hahaokbk/project001/v05/CWIEM_PCB_v05.kicad_pcb

## KiCad design v05/CWIEM_PCB_v05.kicad_pcb (2015-06-16)

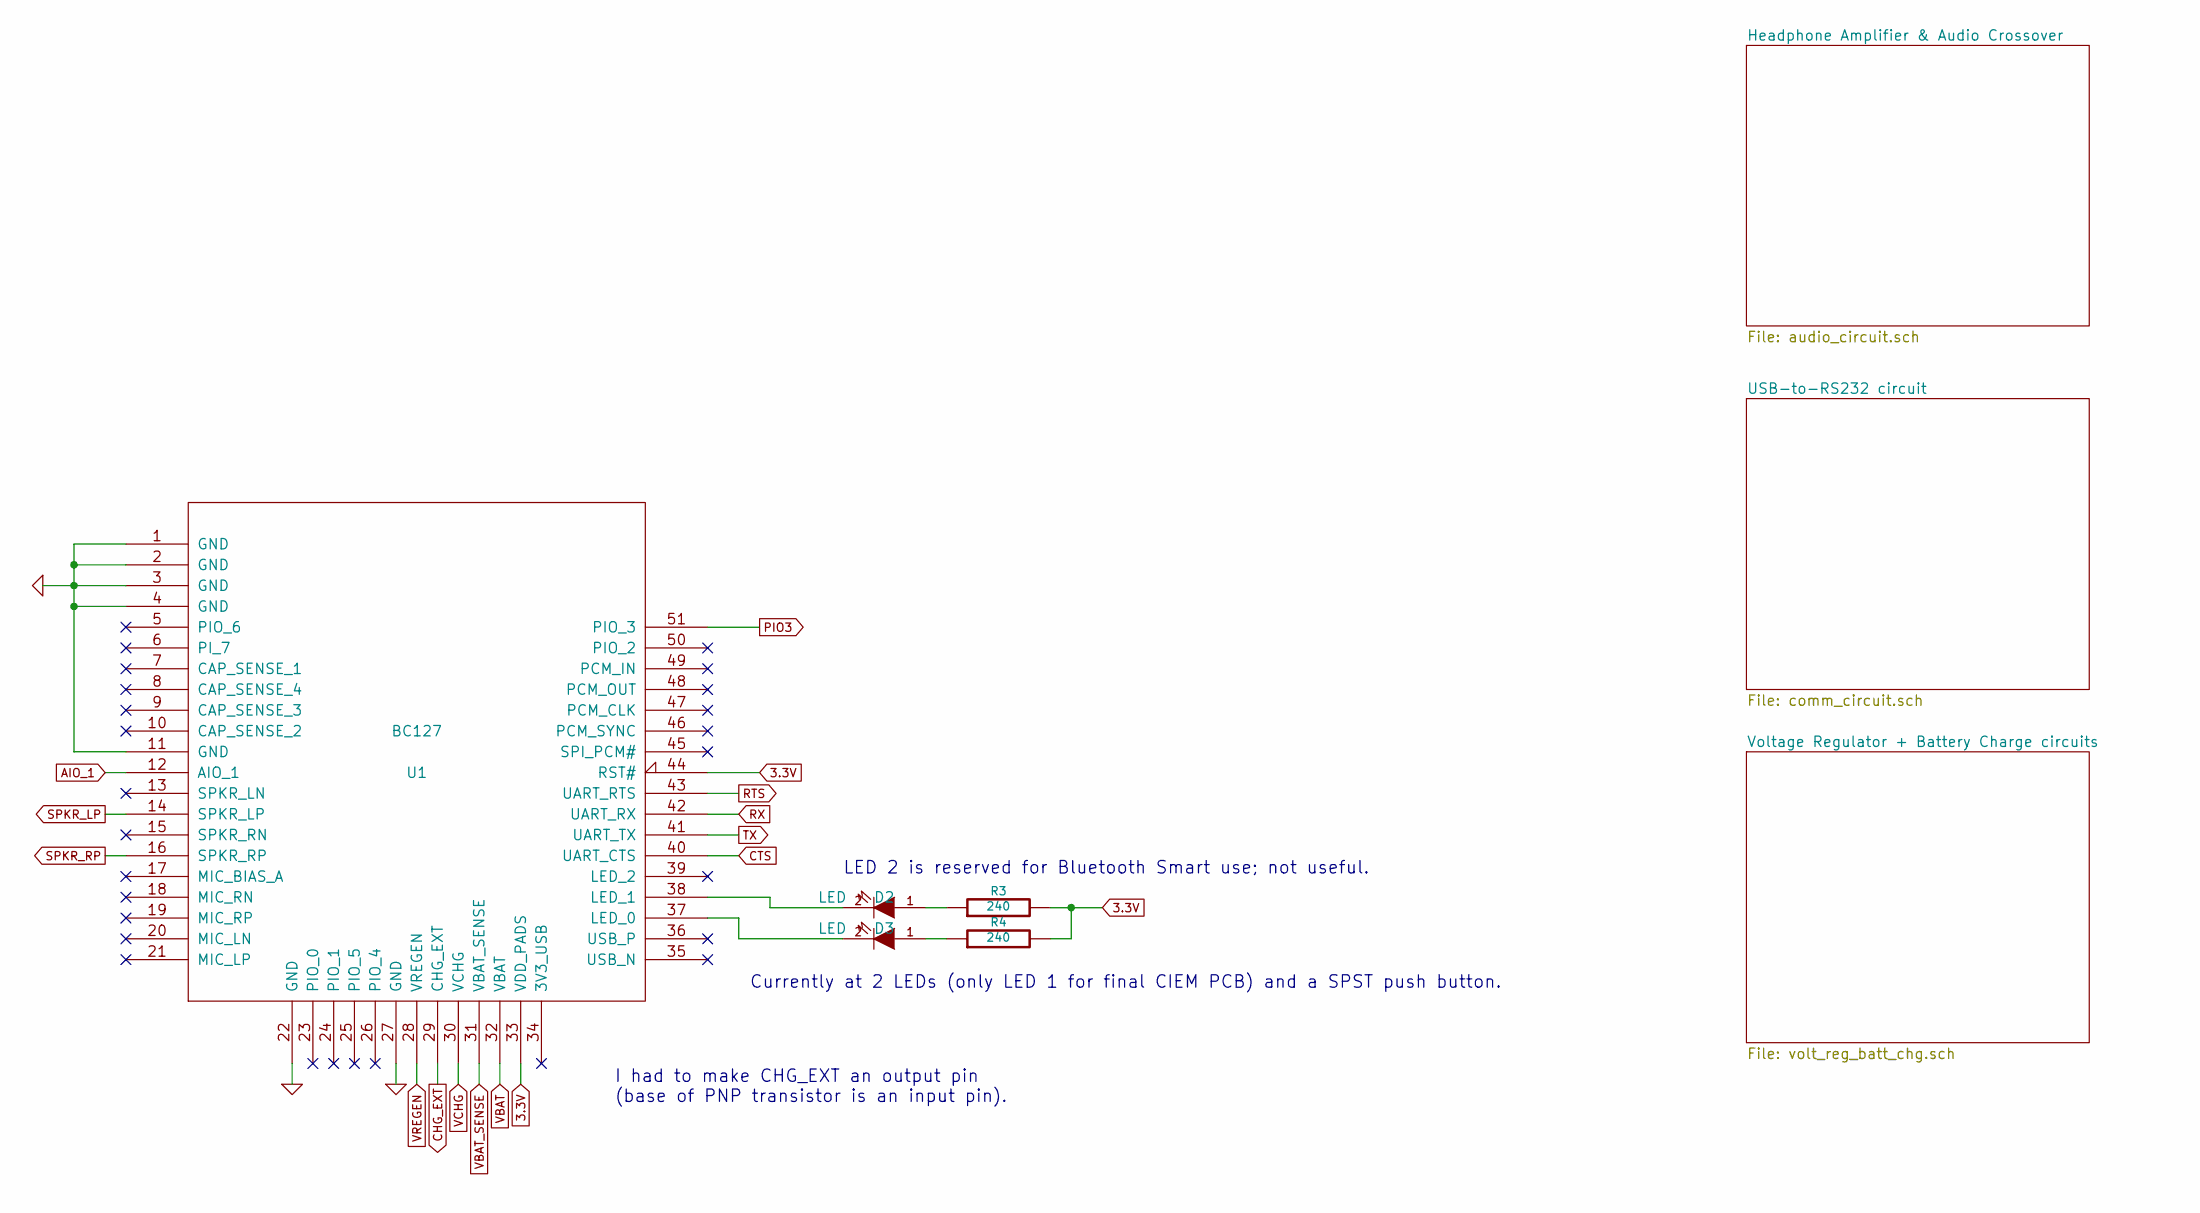
[picture p1: schematic CWIEM_PCB_v05.sch, BC127 circuit]

Parts:
D2, D3: LED
R3, R4: 240
U1: BC127; MODULE

Connections:
3.3V: R3.2, R4.2, U1.33 (VDD_PADS), U1.44 (RST#); also elsewhere on the board
5V_USB: U1.30 (VCHG); also elsewhere on the board
AIO_1: U1.12 (AIO_1); also elsewhere on the board
CHG_EXT: U1.29 (CHG_EXT); also elsewhere on the board
CTS: U1.40 (UART_CTS); also elsewhere on the board
GND: U1.1 (GND), U1.2 (GND), U1.3 (GND), U1.4 (GND), U1.11 (GND), U1.22 (GND), U1.27 (GND); also elsewhere on the board
unnamed: D3.2 (K), U1.37 (LED_0)
unnamed: D2.2 (K), U1.38 (LED_1)
unnamed: D2.1 (A), R3.1
unnamed: D3.1 (A), R4.1
PIO3: U1.51 (PIO_3); also elsewhere on the board
RTS: U1.43 (UART_RTS); also elsewhere on the board
RX: U1.42 (UART_RX); also elsewhere on the board
SPKR_LP: U1.14 (SPKR_LP); also elsewhere on the board
SPKR_RP: U1.16 (SPKR_RP); also elsewhere on the board
TX: U1.41 (UART_TX); also elsewhere on the board
VBAT: U1.32 (VBAT); also elsewhere on the board
VBAT_SENSE: U1.31 (VBAT_SENSE); also elsewhere on the board
VREGEN: U1.28 (VREGEN); also elsewhere on the board

Notes on the sheet:
Currently at 2 LEDs (only LED 1 for final CIEM PCB) and a SPST push button.
I had to make CHG_EXT an output pin (base of PNP transistor is an input pin).
LED 2 is reserved for Bluetooth Smart use; not useful.

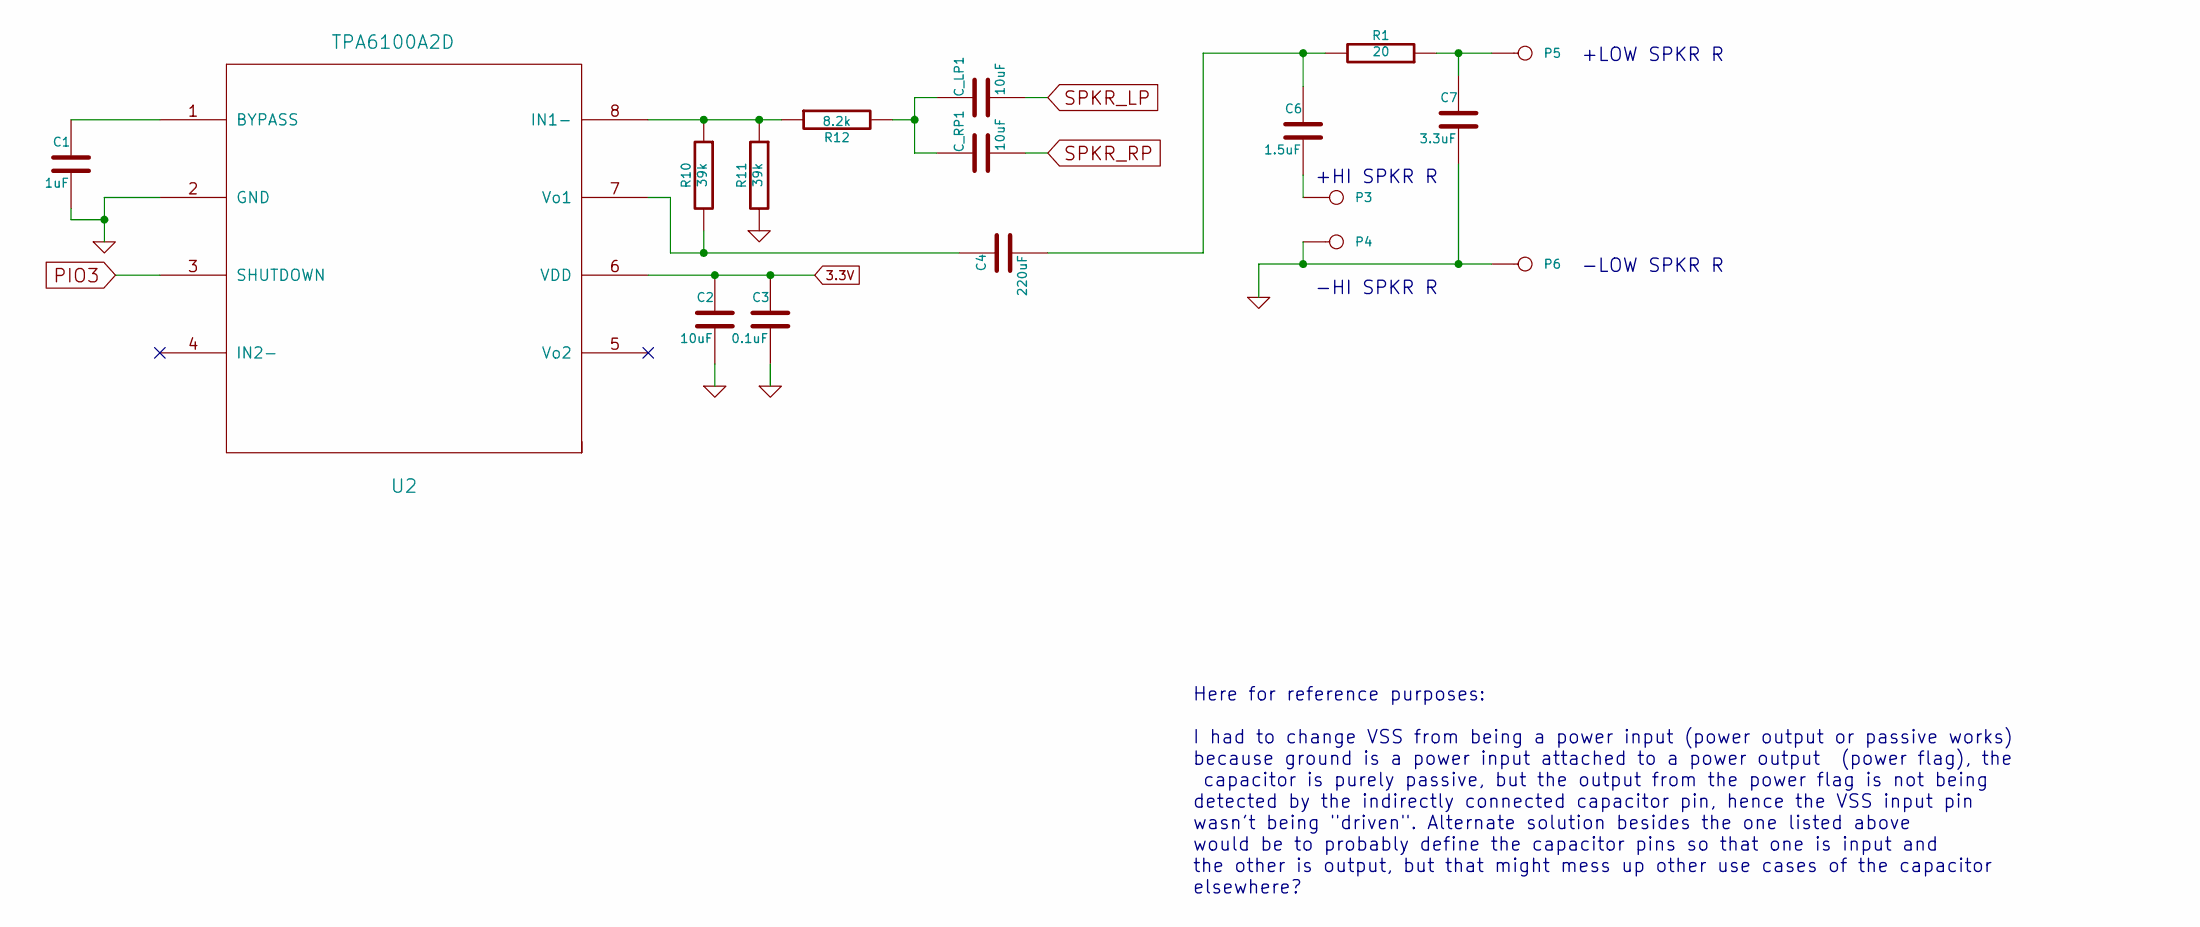
[picture p2: schematic audio_circuit.sch]

Parts:
C1: 1uF
C2: 10uF
C3: 0.1uF
C4: 220uF
C6: 1.5uF
C7: 3.3uF
C_LP1: 10uF
C_RP1: 10uF
P3, P4, P5, P6: CONN_1
R1: 20
R10, R11: 39k
R12: 8.2k
U2: TPA6100A2D

Connections:
3.3V: C2.1, C3.1, U2.6 (VDD); also elsewhere on the board
GND: C1.2, C2.2, C3.2, C7.2, P4.1, P6.1, R11.2, U2.2 (GND); also elsewhere on the board
unnamed: C1.1, U2.1 (BYPASS)
unnamed: R10.1, R11.1, R12.1, U2.8 (IN1-)
unnamed: C4.1, R10.2, U2.7 (Vo1)
unnamed: C6.2, P3.1
unnamed: C4.2, C6.1, R1.2
unnamed: C7.1, P5.1, R1.1
unnamed: C_LP1.1, C_RP1.1, R12.2
PIO3: U2.3 (SHUTDOWN); also elsewhere on the board
SPKR_LP: C_LP1.2; also elsewhere on the board
SPKR_RP: C_RP1.2; also elsewhere on the board

Notes on the sheet:
Here for reference purposes: I had to change VSS from being a power input (power output or passive works) because ground is a power input attached to a power output (power flag), the capacitor is purely passive, but the output from the power flag is not being detected by the indirectly connected ca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
+LOW SPKR R
-LOW SPKR R
+HI SPKR R
-HI SPKR R

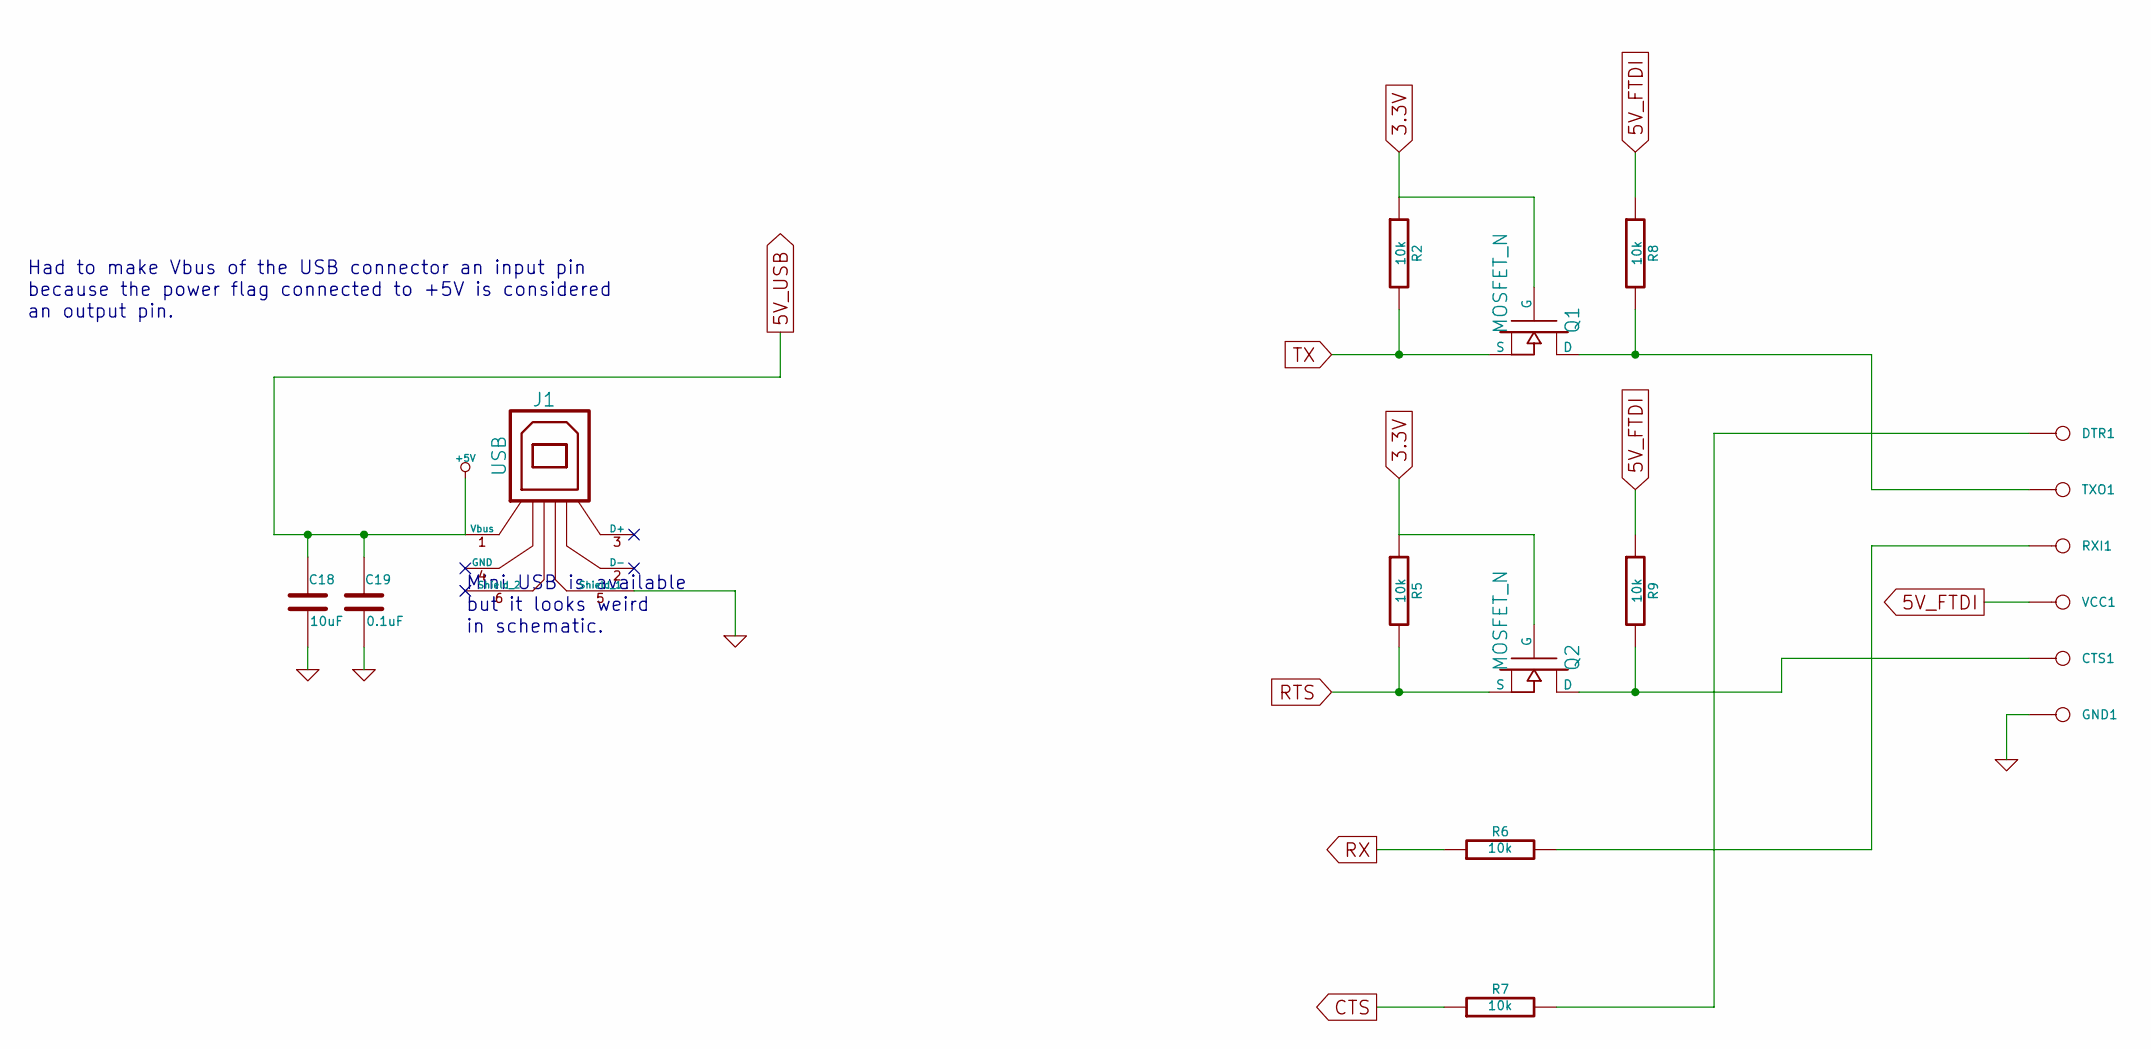
[picture p3: schematic comm_circuit.sch]

Parts:
C18: 10uF
C19: 0.1uF
CTS1: CONN_1
DTR1: CONN_1
GND1: CONN_1
J1: USB
Q1, Q2: MOSFET_N
R2, R5, R6, R7, R8, R9: 10k
RXI1: CONN_1
TXO1: CONN_1
VCC1: CONN_1

Connections:
3.3V: Q1.G, Q2.G, R2.1, R5.1; also elsewhere on the board
5V_FTDI: R8.1, R9.1, VCC1.1
5V_USB: C18.1, C19.1, J1.1 (Vbus); also elsewhere on the board
CTS: R7.1; also elsewhere on the board
GND: C18.2, C19.2, GND1.1, J1.5 (Shield_1); also elsewhere on the board
unnamed: R6.2, RXI1.1
unnamed: CTS1.1, Q2.D, R9.2
unnamed: DTR1.1, R7.2
unnamed: Q1.D, R8.2, TXO1.1
RTS: Q2.S, R5.2; also elsewhere on the board
RX: R6.1; also elsewhere on the board
TX: Q1.S, R2.2; also elsewhere on the board

Notes on the sheet:
Mini USB is available but it looks weird in schematic.
Had to make Vbus of the USB connector an input pin because the power flag connected to +5V is considered an output pin.

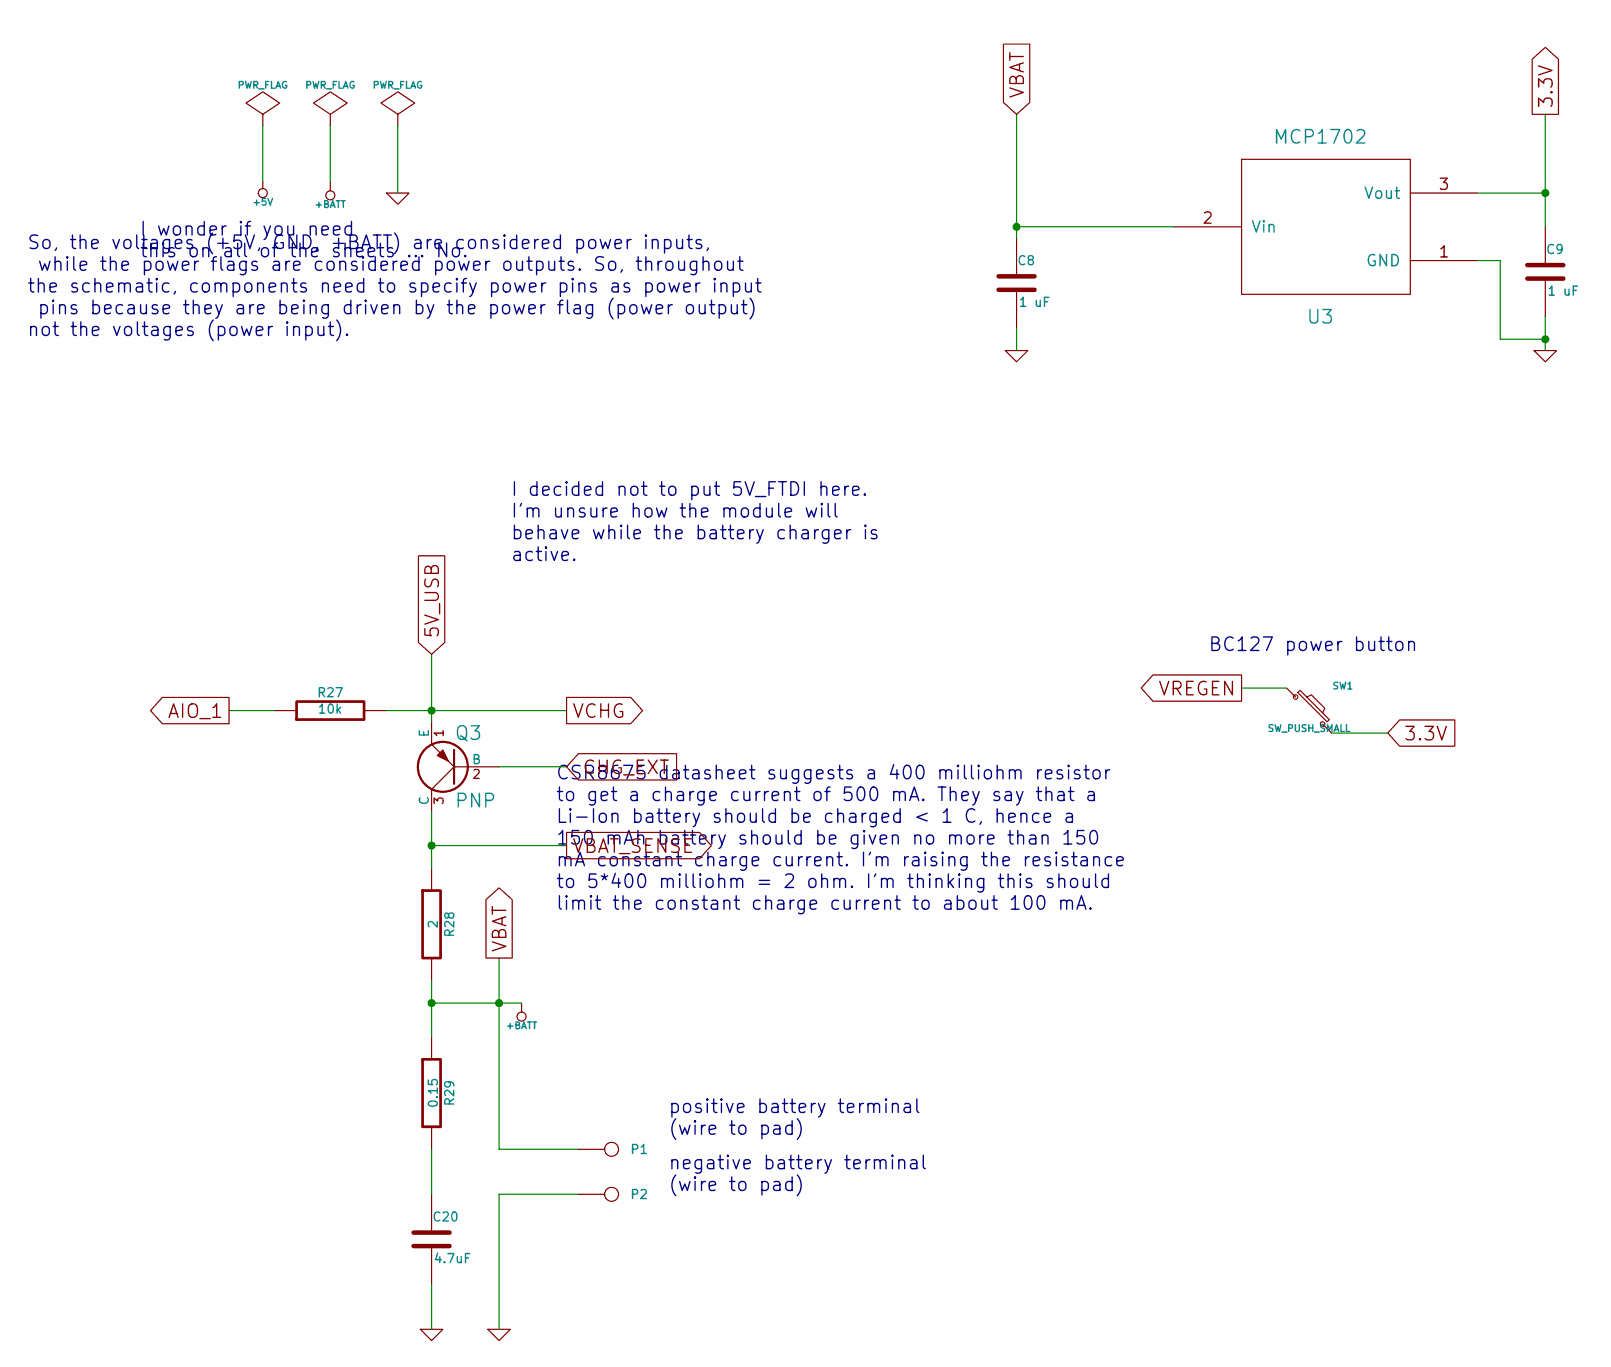
[picture p4: schematic volt_reg_batt_chg.sch]

Parts:
C8, C9: 1 uF
C20: 4.7uF
P1, P2: CONN_1
Q3: PNP
R27: 10k
R28: 2
R29: 0.15
SW1: SW_PUSH_SMALL
U3: MCP1702

Connections:
3.3V: C9.1, SW1.2, U3.3 (Vout); also elsewhere on the board
5V_USB: Q3.1 (E), R27.2; also elsewhere on the board
AIO_1: R27.1; also elsewhere on the board
CHG_EXT: Q3.2 (B); also elsewhere on the board
GND: C8.2, C9.2, C20.2, P2.1, U3.1 (GND); also elsewhere on the board
unnamed: C20.1, R29.2
VBAT: C8.1, P1.1, R28.2, R29.1, U3.2 (Vin); also elsewhere on the board
VBAT_SENSE: Q3.3 (C), R28.1; also elsewhere on the board
VREGEN: SW1.1; also elsewhere on the board

Notes on the sheet:
I wonder if you need this on all of the sheets ... No.
So, the voltages (+5V, GND, +BATT) are considered power inputs, while the power flags are considered power outputs. So, throughout the schematic, components need to specify power pins as power input pins because they are being driven by the power flag (power output) not the voltages (power input).
positive battery terminal (wire to pad)
negative battery terminal (wire to pad)
BC127 power button
CSR8675 datasheet suggests a 400 milliohm resistor to get a charge current of 500 mA. They say that a Li-Ion battery should be charged < 1 C, hence a 150 mAh battery should be given no more than 150 mA constant charge current. I'm raising the resistance to 5*400 milliohm = 2 ohm. I'm thinking this 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
I decided not to put 5V_FTDI here. I'm unsure how the module will behave while the battery charger is active.

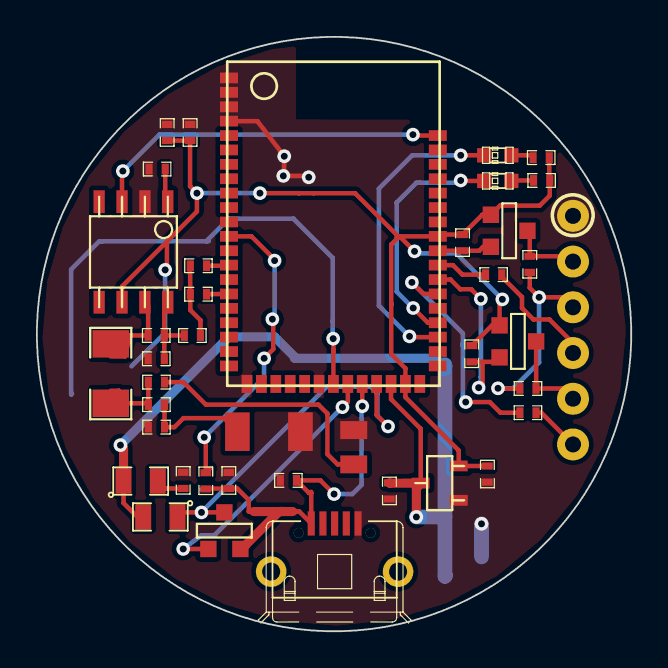
[picture p5: board CWIEM_PCB_v05.kicad_pcb from above]

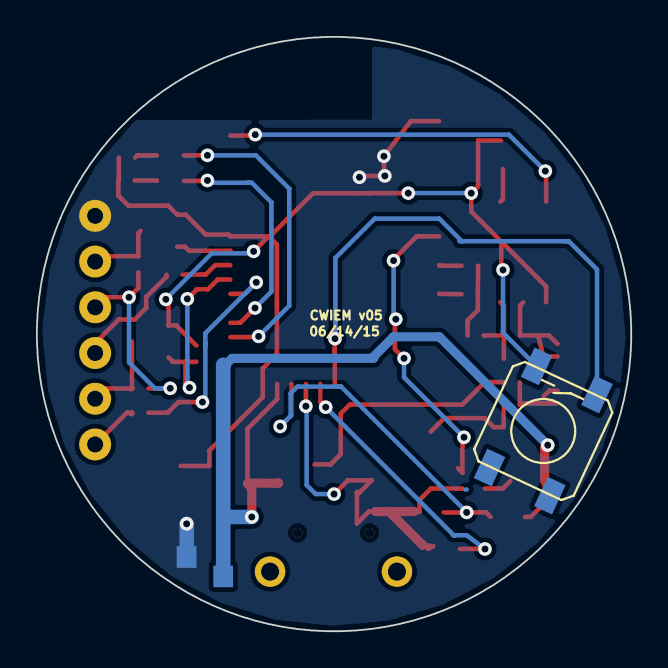
[picture p6: board CWIEM_PCB_v05.kicad_pcb from below]

Board: 2 copper layers, 33.0 x 33.0 mm, 50 parts (3 on the bottom side), 32 nets.
