hahaokbk/project001/v01_R/CWIEM_PCB_v01_R.kicad_pcb

## KiCad design v01_R/CWIEM_PCB_v01_R.kicad_pcb (2015-03-24, an earlier design)

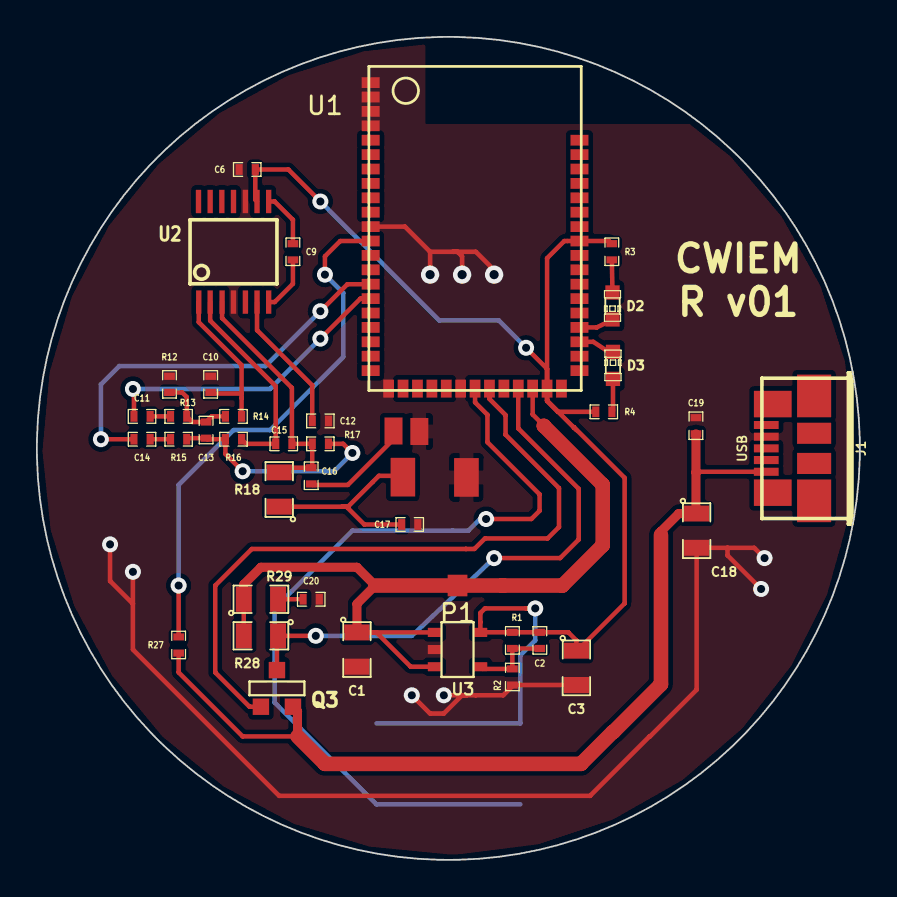
[picture p7: board CWIEM_PCB_v01_R.kicad_pcb from above]

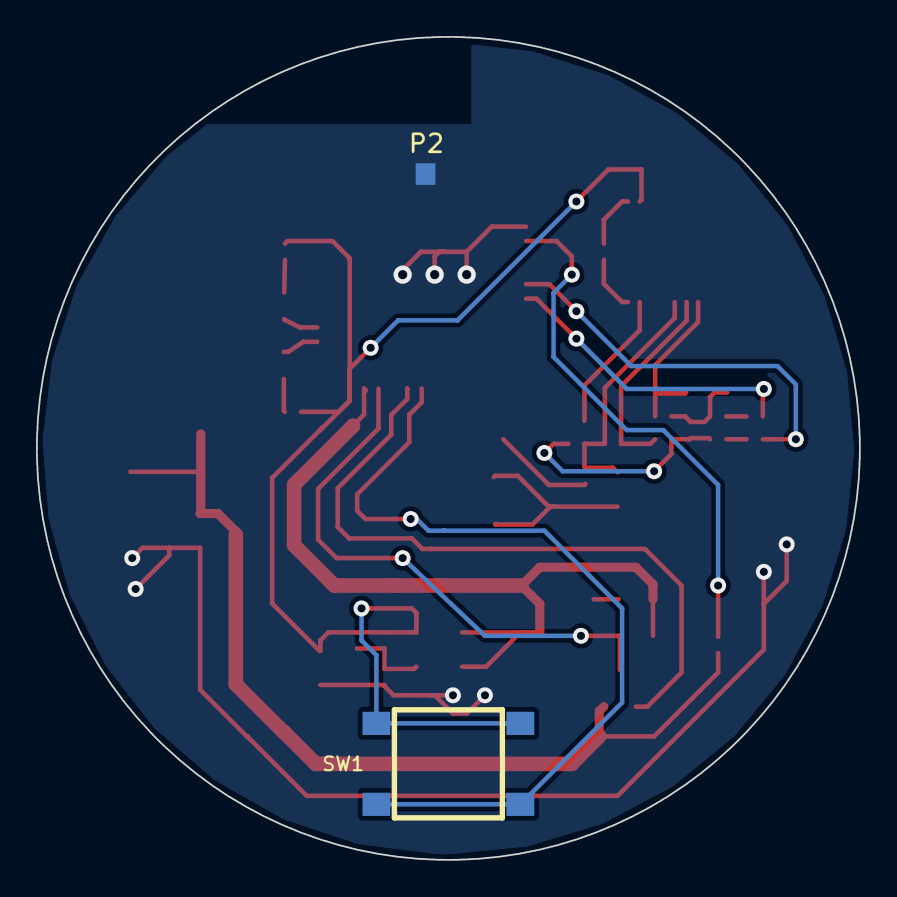
[picture p8: board CWIEM_PCB_v01_R.kicad_pcb from below]

Board: 2 copper layers, 45.7 x 45.7 mm, 44 parts (2 on the bottom side), 28 nets.

Parts:
C1, C3, C18: 10uF; SM0805
C2: 1uF; SM0402_c
C6, C9, C12: 1.0uF; SM0402_c
C10, C15: 47pF; SM0402_c
C11, C14, C19: 0.1uF; SM0402_c
C13: 180pF; SM0402_c
C16: 1.5uF; SM0402_c
C17: 3.3uF; SM0402_c
C20: 4.7uF; SM0402_c
D2, D3: LED; LED-0603
J1: USB; conn_usb_B_micro_smd
P1, P2: CONN_1; BA Driver Pad
P7, P8: CONN_1; wbfk_pad
P9, P12: CONN_1; ci_pad
Q3: PNP; SOT23EBC
R1: 52.3k; SM0402_r
R2, R12, R17: 30.1k; SM0402_r
R3, R4: 240; SM0402_r
R13, R15: 15k; SM0402_r
R14, R16: 43k; SM0402_r
R18: 20; SM0805
R27: 10k; SM0402_r
R28: 0.8; SM0805
R29: 0.15; SM0805
SW1: SW_PUSH_SMALL; SW_PUSH_SMD
U1: BC127
U2: TI_TPA6138A2; TSSOP14
U3: TPS73601DBVR; SOT23-5

Connections:
3.3V: C2.1, C3.1, C6.1, R1.1, R3.2, R4.2, SW1.2, U1.33, U1.44, U2.9, U3.5
5V_USB: C18.1, C19.1, J1.1, Q3.1, R27.2
AIO_1: R27.1, U1.12
CHG_EXT: Q3.2, U1.29
GND: C1.2, C3.2, C6.2, C10.2, C12.2, C17.2, C18.2, C19.2, C20.2, J1.4, P2.1, P8.1, P12.1, R2.2, R12.1, U1.1, U1.2, U1.3, U1.4, U1.11, U1.22, U1.27, U2.4, U2.10, U3.2
unnamed: D2.2, U1.38
unnamed: D3.2, U1.37
unnamed: D2.1, R3.1
unnamed: D3.1, R4.1
unnamed: C13.2, R12.2, R13.1, R14.2
unnamed: C11.2, R13.2
unnamed: C14.2, R15.2
unnamed: C10.1, R14.1, U2.1
unnamed: C17.1, P9.1, R18.1
unnamed: C13.1, R15.1, R16.2, R17.2
unnamed: C9.1, U2.8
unnamed: C9.2, U2.7
unnamed: C12.1, U2.6
unnamed: C16.2, P7.1
unnamed: C15.1, R16.1, U2.2
unnamed: C15.2, C16.1, R17.1, R18.2, U2.3
unnamed: C20.1, R29.2
unnamed: C2.2, R1.2, R2.1, U3.4
SPKR_RN: C14.1, U1.15
SPKR_RP: C11.1, U1.16
VBAT: C1.1, P1.1, R28.2, R29.1, U1.32, U3.1, U3.3
VBAT_SENSE: Q3.3, R28.1, U1.31
VREGEN: SW1.1, U1.28
