hahaokbk/project001/(commit log)

2014-10-18 adding current (10/18/14 1:55 PM) project versions
    [CWIEM_PCB_BC127_v00.sch, CWIEM_PCB_v00.sch, CWIEM_PCB_v01.sch, audio_circuit.sch, comm_circuit.sch, file541BA016.sch, volt_reg_batt_chg.sch]
2014-10-18 Basically just added a single DIP switch to battery charging circuit.
    [CWIEM_PCB_v01.sch, audio_circuit.sch, comm_circuit.sch, volt_reg_batt_chg.sch]
2014-10-25 updates:
    1) added DIP-1 switch to connect/disconnect battery
    2) annotated components in the entire schematic
    3) generated netlist for the schematic
    4) matched components with footprints (caps, DIP switch, diodes, LEDs, I think that's it ...)
    [CWIEM_PCB_v01.sch, audio_circuit.sch, comm_circuit.sch, volt_reg_batt_chg.sch]
2014-12-07 Created BC127 footprint. Associated BC127 component with its footprint. Update to footprint associations.
2015-01-16 Updating with latest edits (haven't committed in a while)
    [CWIEM_PCB_v01.sch, audio_circuit.sch, comm_circuit.sch, volt_reg_batt_chg.sch]
2015-01-16 Splitting v01 (stereo headphone PCB) to v01_R (right headphone PCB)
    [CWIEM_PCB_v01.sch, audio_circuit.sch, comm_circuit.sch, volt_reg_batt_chg.sch]
2015-01-16 Splitting v01 (stereo headphone PCB) to v01_L (left headphone PCB)
    [CWIEM_PCB_v01.sch, audio_circuit.sch, comm_circuit.sch, volt_reg_batt_chg.sch]
2015-01-16 Updating "v01" to "v01_L"
    [CWIEM_PCB_v01_L.sch, audio_circuit.sch, comm_circuit.sch, volt_reg_batt_chg.sch]
2015-01-16 Changing "v01" to "v01_R"
    [CWIEM_PCB_v01_R.sch, audio_circuit.sch, comm_circuit.sch, volt_reg_batt_chg.sch]
2015-01-16 Update includes removing right side of audio circuit
    [CWIEM_PCB_v01_L.sch, audio_circuit.sch, comm_circuit.sch, volt_reg_batt_chg.sch]
2015-01-16 Update removes the left channel of the audio circuit.
    [CWIEM_PCB_v01_R.sch, audio_circuit.sch, comm_circuit.sch, volt_reg_batt_chg.sch]
2015-01-17 Updating entire schematic and footprint selections. Adding jst-ph footprints.
    [CWIEM_PCB_v01_R.sch, audio_circuit.sch, comm_circuit.sch, volt_reg_batt_chg.sch]
2015-01-20 Adding very rough initial version of PCB. The BA driver pads were not exact yet (based off of a Sonion driver datasheet).
    [CWIEM_PCB_v01_R.sch, audio_circuit.sch, comm_circuit.sch, volt_reg_batt_chg.sch]
2015-01-20 Adding balanced armature driver pad and a module library with a SMD pushbutton.
2015-01-20 The rough initial version of the PCB.
    [CWIEM_PCB_v01_R.kicad_pcb]
2015-01-25 Update with 2.00" diameter version of the CWIEM R v01 PCB. The only change remaining was to finalize sound driver pad placement and sizing. After that, production files could be generated for board m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
    [CWIEM_PCB_v01_R.kicad_pcb, CWIEM_PCB_v01_R.sch, audio_circuit.sch, comm_circuit.sch, volt_reg_batt_chg.sch]
2015-01-31 Updating with CWIEM R v01 (1.8 inch diameter edition)
    [CWIEM_PCB_v01_R.kicad_pcb, CWIEM_PCB_v01_R.sch, audio_circuit.sch, comm_circuit.sch, volt_reg_batt_chg.sch]
2015-01-31 Adding some audio speaker pad footprints and micro B USB footprint
2015-01-31 Updating PCB silkscreen (some part numbers were under the parts) and adding a zipped folder with first PCB files for order.
    [CWIEM_PCB_v01_R.kicad_pcb]
2015-02-26 Adding CWIEM v02 (left) -- goal is to fit design on 1.3" diameter circular PCB
    [CWIEM_PCB_v02_L.sch, audio_circuit.sch, comm_circuit.sch, volt_reg_batt_chg.sch]
2015-02-26 Adding CWIEM v02 (right) -- the goal is to fit the v01 design onto a 1.3-inch diameter PCB
    [CWIEM_PCB_v02_R.sch, audio_circuit.sch, comm_circuit.sch, volt_reg_batt_chg.sch]
2015-02-28 Adding TE Connectivity Micro USB PCB footprint
2015-02-28 Update -- order submitted to OSHPark
    [CWIEM_PCB_v02_R.kicad_pcb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]
2015-03-24 Modifying micro USB port drill hole dimensions and distance
2015-03-24 Just submitting whatever I last changed.
    [CWIEM_PCB_v02_R.kicad_pcb]
2015-03-24 Submitting design CWIEM PCB R v03.
    Changelog:
    1) (pcb) remove extra tracks for pushbutton
    2) (module editor) fix usb port drill dimensions
    3) (schematic/pcb) connect VCHG pin
    4) (schematic/pcb) connect MUTE pin
    5) (pcb) replace battery connector pads
    6) (pcb) rework 3.3V connections
    7) (pcb) update board title (and add date on back)
    [CWIEM_PCB_v03_R-B_Cu.gbl, CWIEM_PCB_v03_R-B_Mask.gbs, CWIEM_PCB_v03_R-B_SilkS.gbo, CWIEM_PCB_v03_R-Edge_Cuts.gbr, CWIEM_PCB_v03_R-F_Cu.gtl, CWIEM_PCB_v03_R-F_Mask.gts, CWIEM_PCB_v03_R-F_SilkS.gto, CWIEM_PCB_v03_R.drl]
2015-03-24 Submitting the latest stuff.
    [CWIEM_PCB_v01_R.kicad_pcb]
2015-04-13 Adding CWIEM PCB R v04 -- adds a power-efficient voltage regulator, adds a power-efficient headphone driver, and corrects for USB ground issue
    [CWIEM_PCB_v04_R-B_Cu.gbl, CWIEM_PCB_v04_R-B_Mask.gbs, CWIEM_PCB_v04_R-B_SilkS.gbo, CWIEM_PCB_v04_R-Edge_Cuts.gbr, CWIEM_PCB_v04_R-F_Cu.gtl, CWIEM_PCB_v04_R-F_Mask.gts, CWIEM_PCB_v04_R-F_SilkS.gto, CWIEM_PCB_v04_R.drl]
2015-06-05 Adding CWIEM BCB L v04
    [CWIEM_PCB_v04_L-B_Cu.gbl, CWIEM_PCB_v04_L-B_Mask.gbs, CWIEM_PCB_v04_L-B_SilkS.gbo, CWIEM_PCB_v04_L-Edge_Cuts.gbr, CWIEM_PCB_v04_L-F_Cu.gtl, CWIEM_PCB_v04_L-F_Mask.gts, CWIEM_PCB_v04_L-F_SilkS.gto, CWIEM_PCB_v04_L.drl]
2015-06-16 Add CWIEM PCB v05
    [CWIEM_PCB_v05-B_Cu.gbl, CWIEM_PCB_v05-B_Mask.gbs, CWIEM_PCB_v05-B_SilkS.gbo, CWIEM_PCB_v05-Edge_Cuts.gbr, CWIEM_PCB_v05-F_Cu.gtl, CWIEM_PCB_v05-F_Mask.gts, CWIEM_PCB_v05-F_SilkS.gto, CWIEM_PCB_v05.drl]
